Makerfabs/Home-Assistant-Mic-and-Speaker/README.md

# Makerfabs Home Assistant Mic and Speaker

## Intruduce
[Product Link]()

[Wiki Link]()
