Makerfabs/Home-Assistant-Mic-and-Speaker/Hardware/Mic and Speaker for Home Assistant V2.0.PDF

# POWER

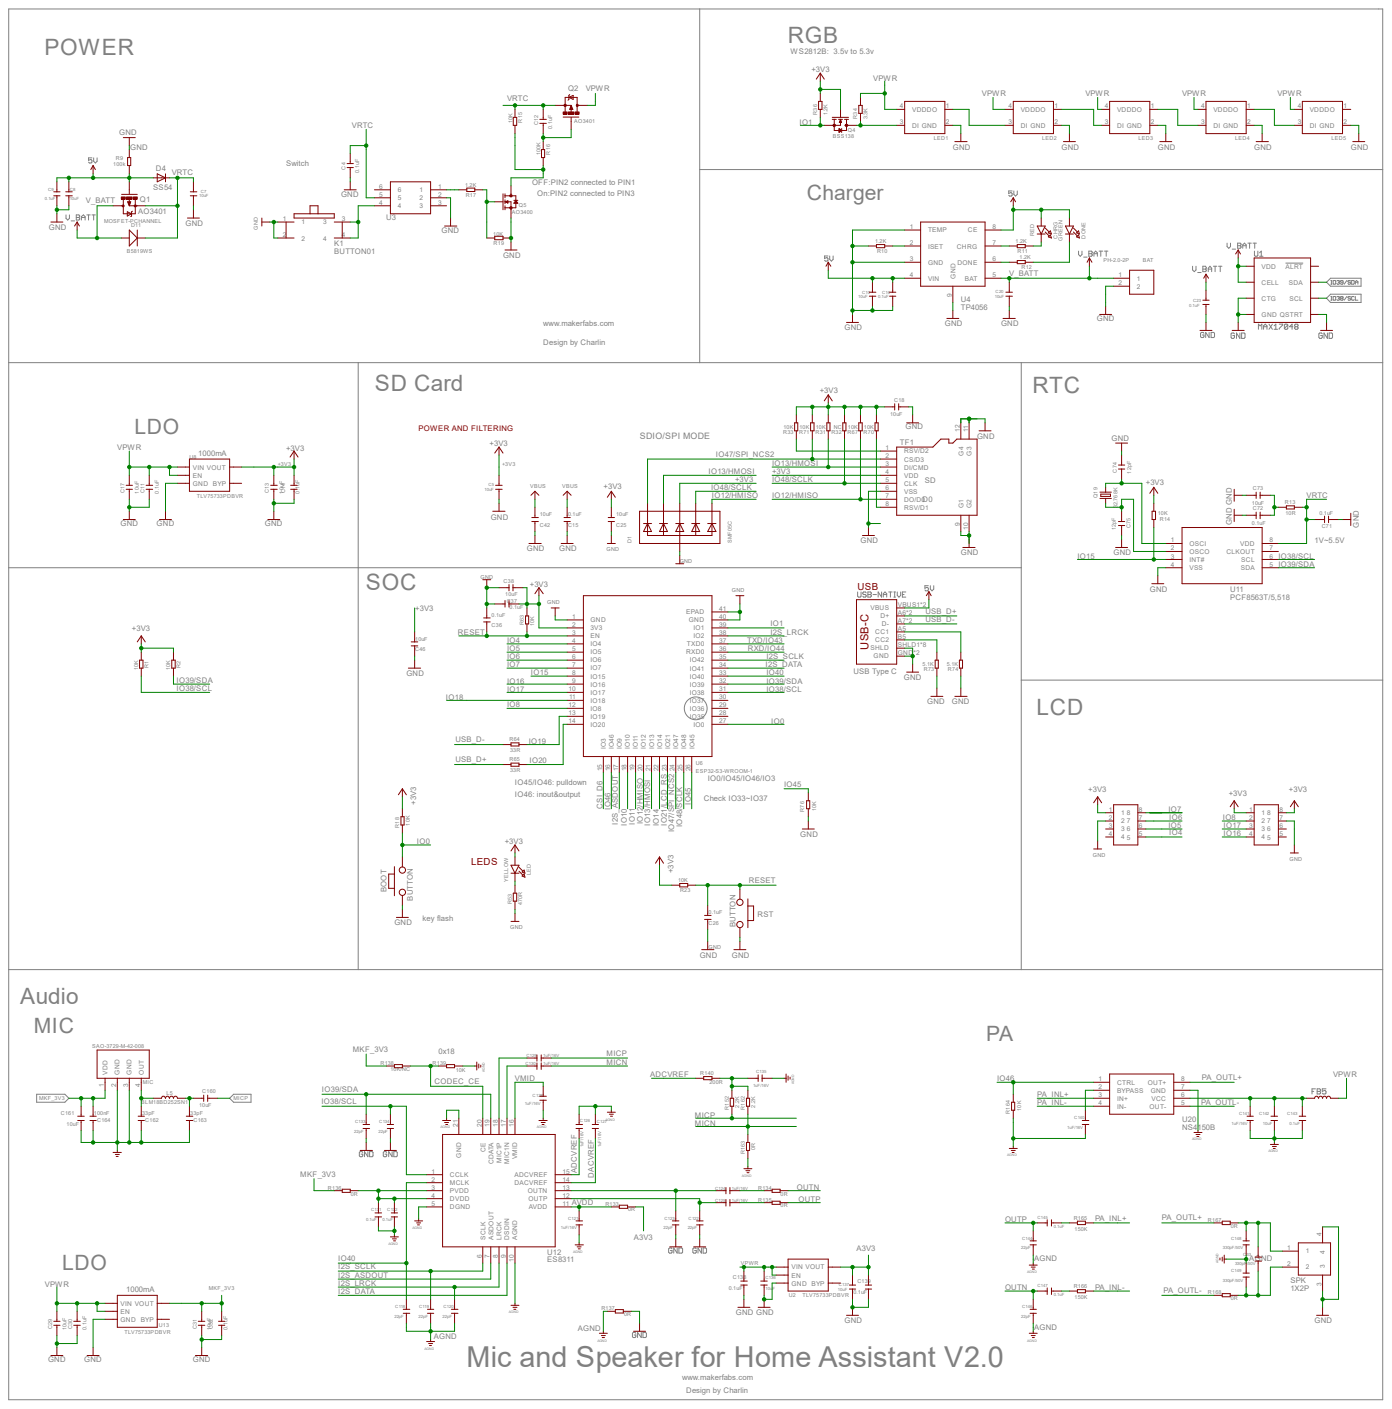
[picture p1: page 1]

IO13/HMOSI | | DI/CMD 3

RSV/D2 1 CS/D3 2 SD D0

+3V3 IO48/SCLK | CLK 5
