Makerfabs/Home-Assistant-Mic-and-Speaker/Hardware/HA LCD1.14 V2.0.PDF

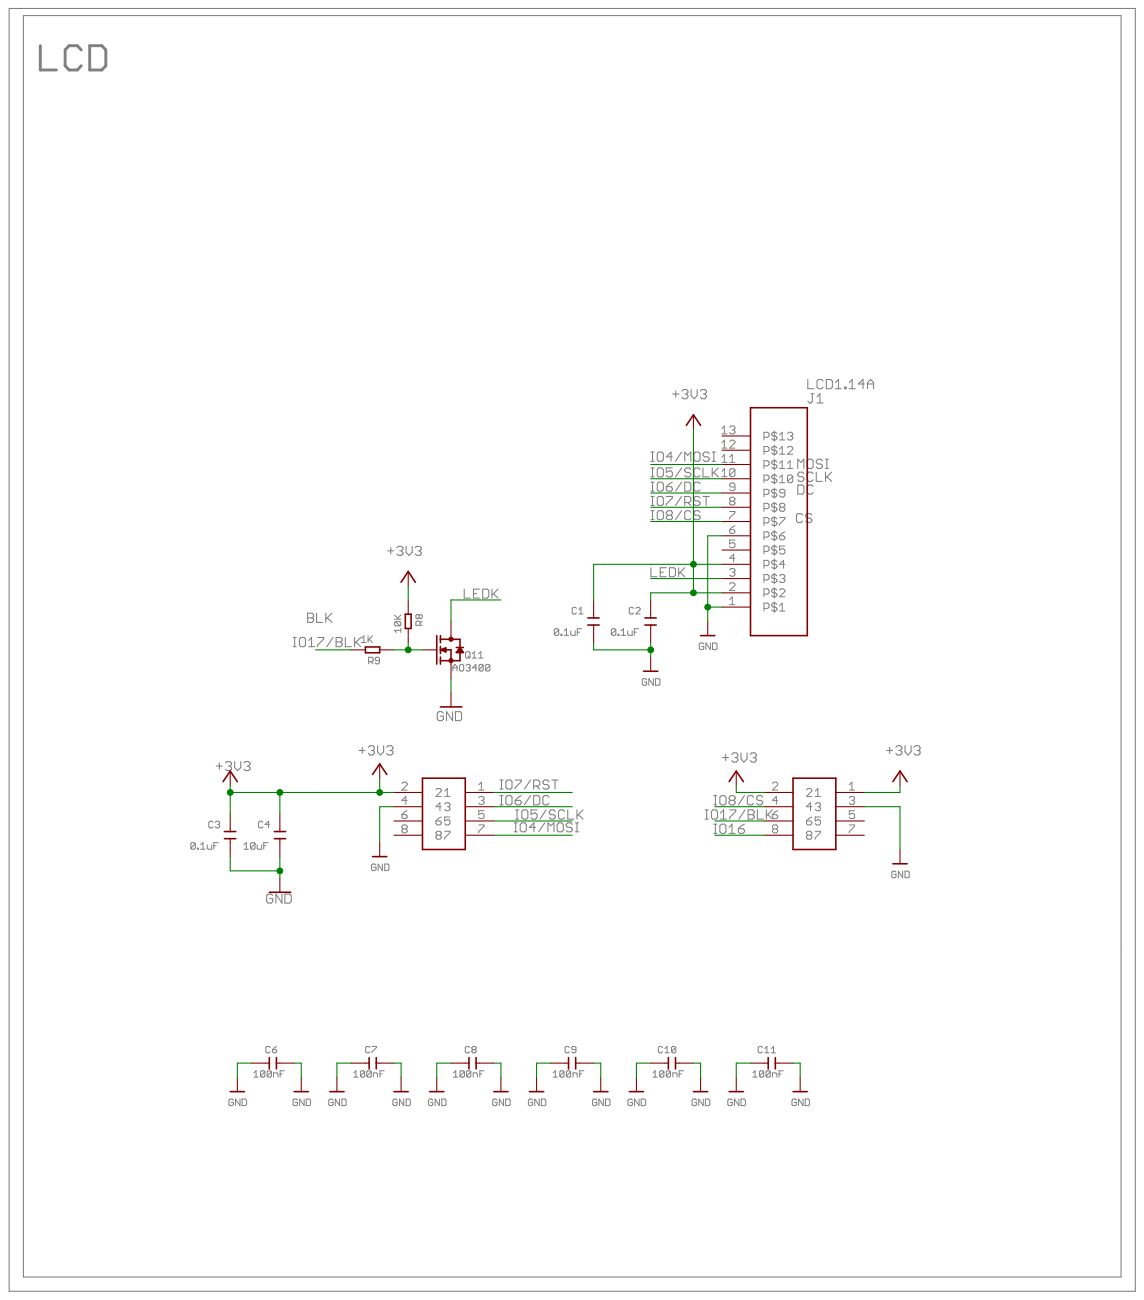
[picture p2: page 1]
