Makerfabs/Home-Assistant-Mic-and-Speaker/Hardware/Mic and Speaker for Home Assistant V2.0.brd

## EAGLE design Hardware/Mic and Speaker for Home Assistant V2.0.brd (2026-05-20)

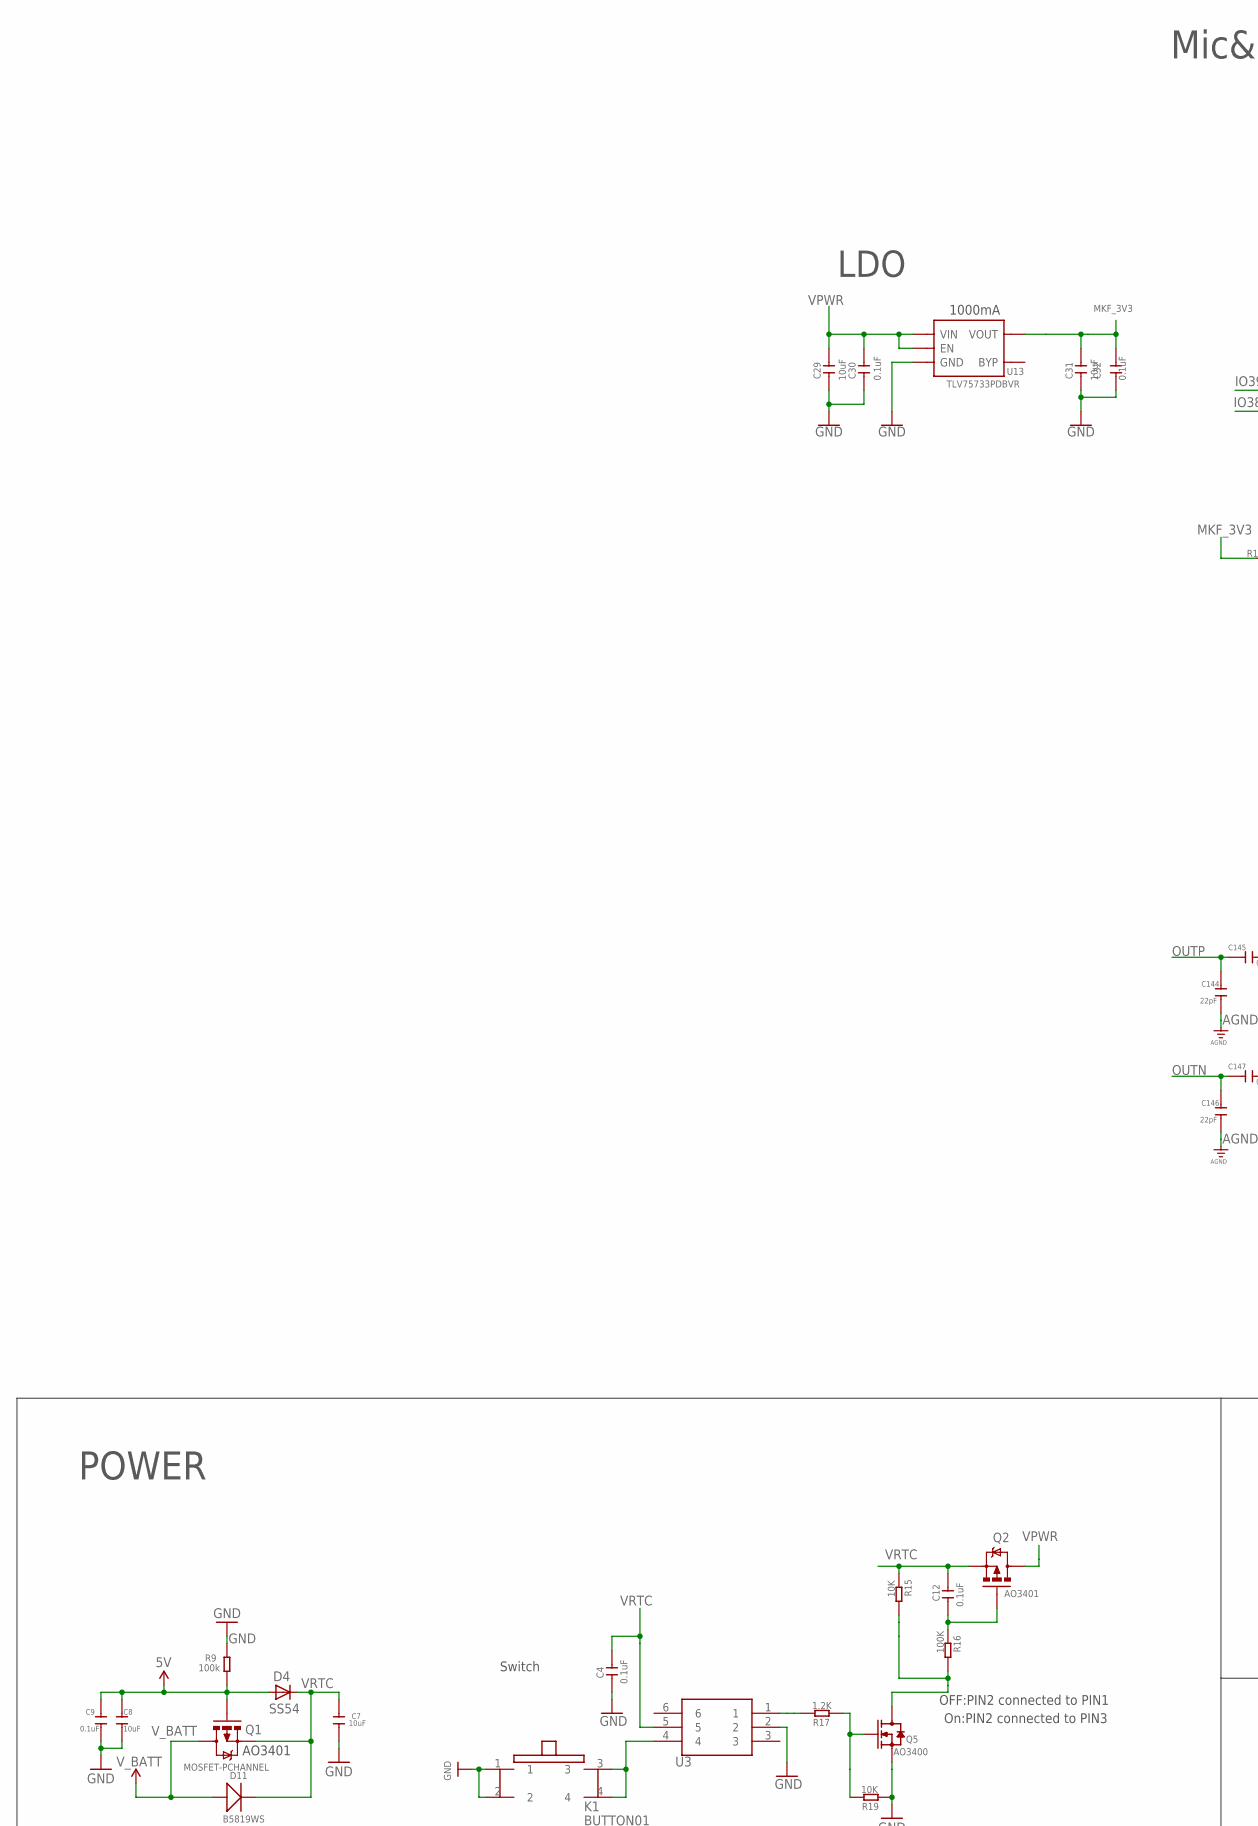
[picture p3: schematic Mic and Speaker for Home Assistant V2.0.sch, part in row 1, column 1]

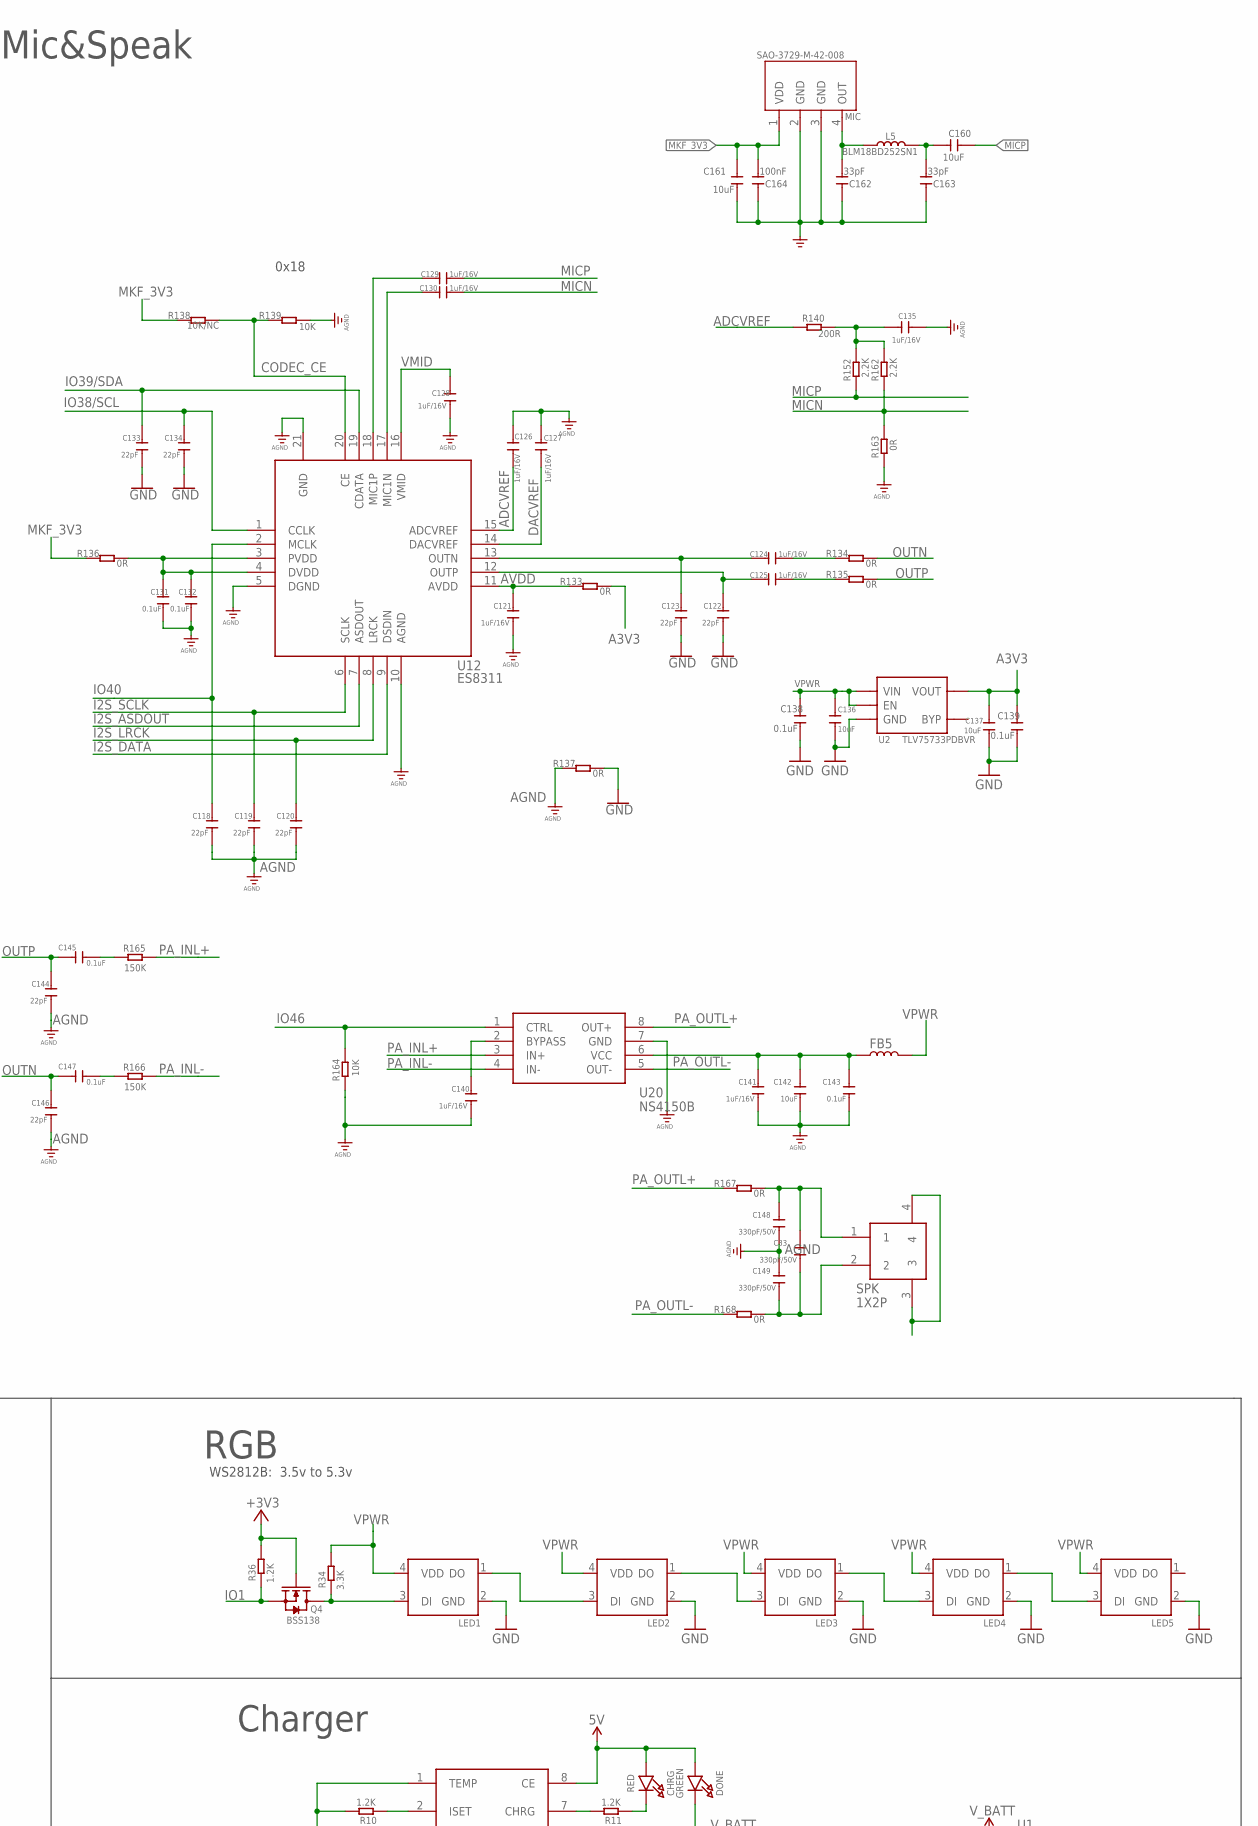
[picture p4: schematic Mic and Speaker for Home Assistant V2.0.sch, part in row 1, column 2]

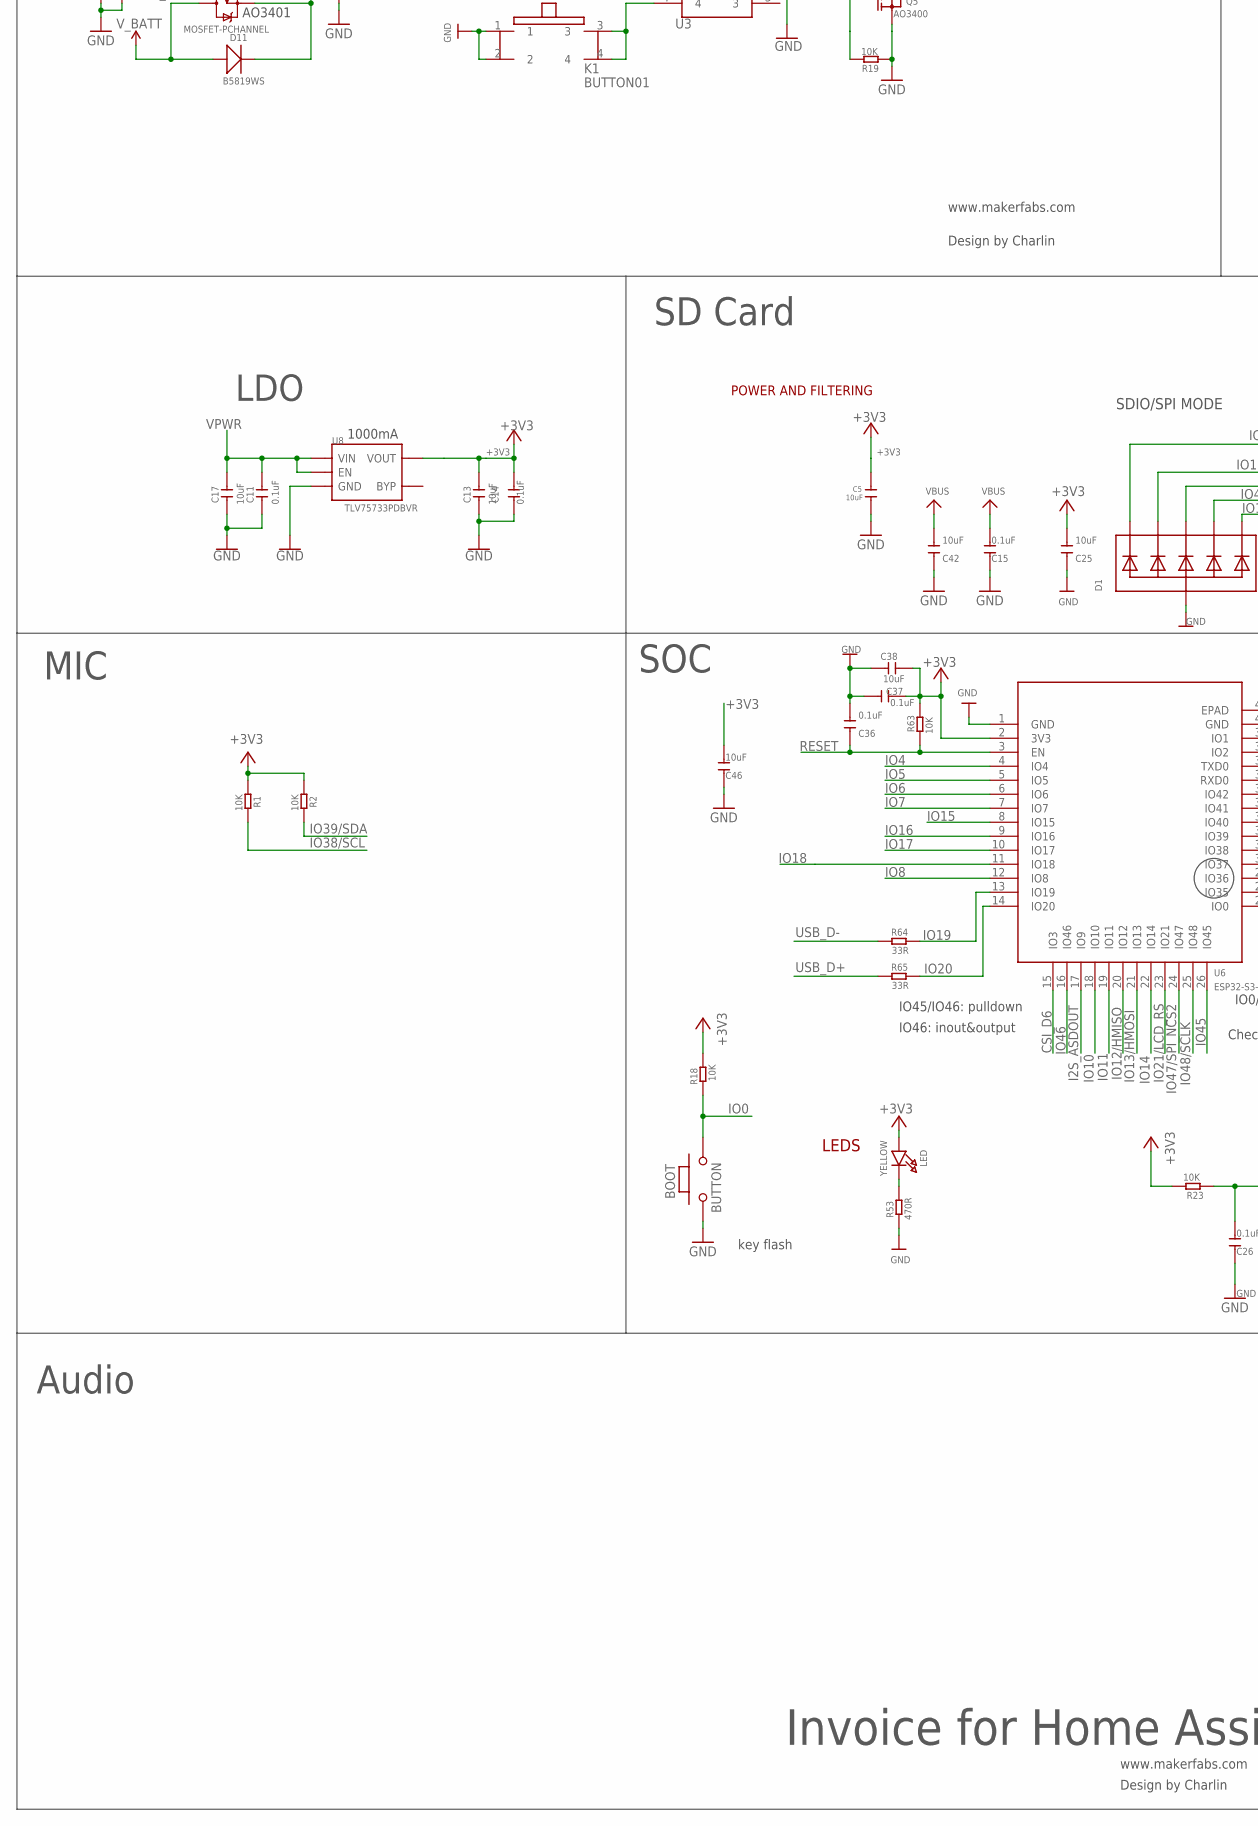
[picture p5: schematic Mic and Speaker for Home Assistant V2.0.sch, part in row 2, column 1]

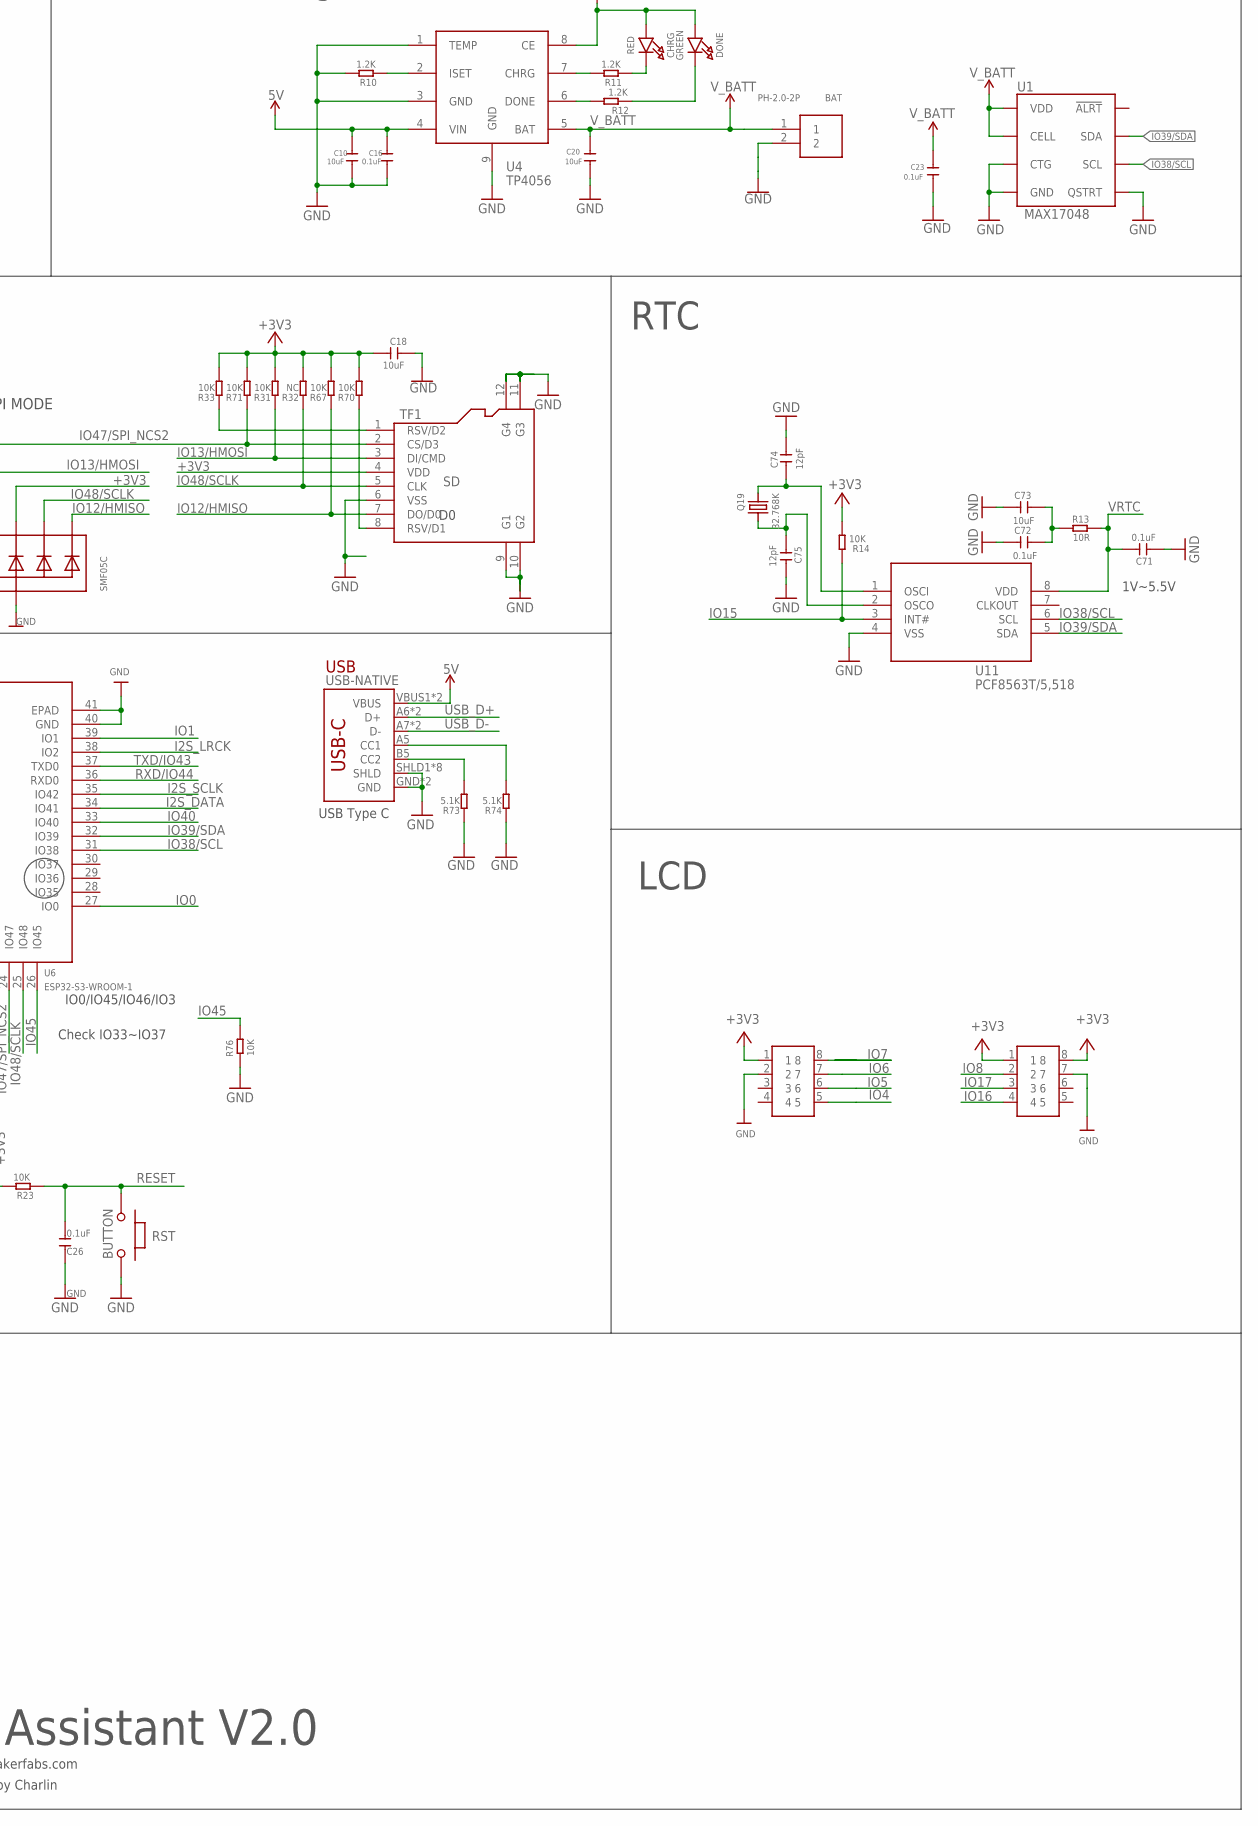
[picture p6: schematic Mic and Speaker for Home Assistant V2.0.sch, part in row 2, column 2]

Parts:
BAT: PH-2.0-2P
BOOT: BUTTON; 157SW
C4, C11, C12, C14, C15, C26, C30, C32, C36, C37, C71, C72: 0.1uF; DISCRETE_C0603
C5, C7, C8, C10, C20, C136, C137, C142, C160, C161: 10uF; C0603
C9, C16, C23, C131, C132, C138, C139, C143, C145, C147: 0.1uF; C0603
C13, C17, C18, C25, C29, C31, C38, C42, C46, C73: 10uF; DISCRETE_C0603
C33, C148, C149: 330pF/50V; C0603
C74, C75: 12pF; DISCRETE_C0603
C118, C119, C120, C122, C123, C133, C134, C144, C146: 22pF; C0603
C121, C124, C125, C126, C127, C128, C129, C130, C135, C140, C141: 1uF/16V; C0603
C162, C163: 33pF; C0603
C164: 100nF; C0603
CHRG: RED; CHIPLED_0805_NOOUTLINE
D1: SMF05C; SOT363
D4: SS54; DO-214AC
D11: B5819WS; SOD323
DONE: GREEN; CHIPLED_0805_NOOUTLINE
FB5: INDUCTORFB-30OHM; 0603
J1, J2: CON2X4-254P-B; CON2X4-2.54MM-THD
K1: BUTTON01
L5: BLM18BD252SN1; L0603
LED: YELLOW; CHIPLED_0805_NOOUTLINE
LED1, LED2, LED3, LED4, LED5: WS2812B-2020
MIC: SAO-3729-M-42-008; MIC4-SMD-3.76X2.95MM
Q1: MOSFET-PCHANNEL; SOT23-3
Q2: AO3401; SOT23-3
Q4: BSS138; SOT23@1
Q5: AO3400; SOT23@1
Q19: 32.768K; XTAL3215
R1, R2, R14, R15, R18, R19, R23, R63, R76, R139, R164: 10K; R0603
R9: 100k; R0603
R10, R11, R12, R17, R36: 1.2K; R0603
R13: 10R; R0603
R16: 100K; R0603
R31, R33, R67, R70, R71: 10K; DISCRETE_R0603
R32: NC; DISCRETE_R0603
R34: 3.3K; R0603
R53: 470R; R0603
R64, R65: 33R; R0603
R73, R74: 5.1K; DISCRETE_R0603
R133, R134, R135, R136, R137, R163, R167, R168: 0R; R0603
R138: 10K/NC; R0603
R140: 200R; R0603
R152, R162: 2.2K; R0603
R165, R166: 150K; R0603
RST: BUTTON; 157SW
SPK: 1X2P; 1X2P-SMT1.25MM
TF1: SD; 8P-SMD
U1: MAX17048; DFN-8
U2, U8, U13: TLV75733PDBVR; SOT23-5
U3: SW01A; SOT23-6-95P-300L300W
U4: TP4056; SOP8-1.27P
U6: ESP32-S3-WROOM-1
U11: PCF8563T/5,518; SOP8
U12: ES8311; QFN20-40P-300L300W55H
U20: NS4150B; MSOP8-65P-490L300W110H
USB-NATIVE: USB_C5; USB-C-16P-5

Connections:
5V: C8.2, C9.1, C10.1, C16.1, CHRG.A, D4.A, DONE.A, Q1.1 (G), R9.1, U4.4 (VIN), U4.8 (CE), USB-NATIVE.VBUS1 (VBUS), USB-NATIVE.VBUS2 (VBUS)
+3V3: C5.1, C13.2, C14.2, C18.2, C25.2, C37.1, C38.1, C46.2, D1.4 (C3), J1.1, J2.1, J2.8, LED.A, Q4.1 (G), R1.1, R2.1, R14.1, R18.2, R23.2, R31.2, R32.2, R33.2, R36.2, R63.2, R67.2, R70.2, R71.2, TF1.4 (VDD), U6.2 (3V3), U8.5 (VOUT)
A3V3: C137.1, C139.2, R133.2, U2.5 (VOUT)
ADCVREF: C126.2, R140.1, U12.15 (ADCVREF)
AGND: C118.2, C119.2, C120.2, C121.2, C126.1, C127.1, C128.2, C131.2, C132.2, C135.2, C140.2, C141.2, C142.2, C143.2, C144.2, C146.2, C148.2, C149.1, C161.1, C162.2, C163.2, C164.2, MIC.2 (GND), MIC.3 (GND), R137.1, R139.2, R163.1, R164.1, U12.5 (DGND), U12.10 (AGND), U12.21 (GND), U20.7 (GND)
AVDD: C121.1, R133.1, U12.11 (AVDD)
CODEC_CE: R138.2, R139.1, U12.20 (CE)
CSI_D6: U6.15 (IO3)
DACVREF: C127.2, U12.14 (DACVREF)
GND: BAT.2, BOOT.1, C4.1, C5.2, C7.1, C8.1, C9.2, C10.2, C11.1, C13.1, C14.1, C15.1, C16.2, C17.1, C18.1, C20.2, C23.2, C25.1, C26.1, C29.1, C30.1, C31.1, C32.1, C36.2, C37.2, C38.2, C42.1, C46.1, C71.1, C72.1, C73.1, C74.2, C75.2, C122.2, C123.2, C133.2, C134.2, C136.2, C137.2, C138.1, C139.1, D1.2 (A), J1.2, J2.7, K1.1, K1.2, LED1.2 (GND), LED2.2 (GND), LED3.2 (GND), LED4.2 (GND), LED5.2 (GND), Q5.2 (S), R9.2, R10.2, R19.1, R53.1, R73.1, R74.1, R76.1, R137.2, RST.1, SPK.3, SPK.4, TF1.6 (VSS), TF1.9 (G1), TF1.10 (G2), TF1.11 (G3), TF1.12 (G4), U1.1 (CTG), U1.4 (GND), U1.6 (QSTRT), U1.9 (GND), U2.2 (GND), U3.2, U4.1 (TEMP), U4.3 (GND), U4.9 (GND), U6.1 (GND), U6.40 (GND), U6.41 (EPAD), U8.2 (GND), U11.4 (VSS), U13.2 (GND), USB-NATIVE.GND, USB-NATIVE.GND2 (GND), USB-NATIVE.SHLD1 (SHLD), USB-NATIVE.SHLD2 (SHLD), USB-NATIVE.SHLD3 (SHLD), USB-NATIVE.SHLD4 (SHLD), USB-NATIVE.SHLD5 (SHLD), USB-NATIVE.SHLD6 (SHLD), USB-NATIVE.SHLD7 (SHLD), USB-NATIVE.SHLD8 (SHLD)
I2S_ASDOUT: U6.17 (IO9), U12.7 (ASDOUT)
I2S_DATA: U6.34 (IO41), U12.9 (DSDIN)
I2S_LRCK: C120.1, U6.38 (IO2), U12.8 (LRCK)
I2S_SCLK: C119.1, U6.35 (IO42), U12.6 (SCLK)
IO0: BOOT.2, R18.1, U6.27 (IO0)
IO1: Q4.2 (S), R36.1, U6.39 (IO1)
IO4: J1.5, U6.4 (IO4)
IO5: J1.6, U6.5 (IO5)
IO6: J1.7, U6.6 (IO6)
IO7: J1.8, U6.7 (IO7)
IO8: J2.2, U6.12 (IO8)
IO10: U6.18 (IO10)
IO11: U6.19 (IO11)
IO12/HMISO: D1.6 (C5), R67.1, TF1.7 (DO/D0), U6.20 (IO12)
IO13/HMOSI: D1.3 (C2), R31.1, TF1.3 (DI/CMD), U6.21 (IO13)
IO14: U6.22 (IO14)
IO15: R14.2, U6.8 (IO15), U11.3 (INT#)
IO16: J2.4, U6.9 (IO16)
IO17: J2.3, U6.10 (IO17)
IO18: U6.11 (IO18)
IO19: R64.2, U6.13 (IO19)
IO20: R65.2, U6.14 (IO20)
IO21/LCD_RS: U6.23 (IO21)
IO38/SCL: C134.1, R1.2, U1.7 (SCL), U6.31 (IO38), U11.6 (SCL), U12.1 (CCLK)
IO39/SDA: C133.1, R2.2, U1.8 (SDA), U6.32 (IO39), U11.5 (SDA), U12.19 (CDATA)
IO40: C118.1, U6.33 (IO40), U12.2 (MCLK)
IO45: R76.2, U6.26 (IO45)
IO46: R164.2, U6.16 (IO46), U20.1 (CTRL)
IO47/SPI_NCS2: D1.1 (C1), R71.1, TF1.2 (CS/D3), U6.24 (IO47)
IO48/SCLK: D1.5 (C4), R32.1, TF1.5 (CLK), U6.25 (IO48)
MICN: C130.2, R162.1, R163.2
MICP: C129.2, C160.2, R152.1
MKF_3V3: C31.2, C32.2, C161.2, C164.1, MIC.1 (VDD), R136.1, R138.1, U13.5 (VOUT)
unnamed: R10.1, U4.2 (ISET)
unnamed: R11.2, U4.7 (CHRG)
unnamed: R12.2, U4.6 (DONE)
unnamed: C12.1, Q2.1 (G), R16.1
unnamed: CHRG.C, R11.1
unnamed: DONE.C, R12.1
unnamed: Q5.3 (D), R15.2, R16.2
unnamed: LED.C, R53.2
unnamed: LED1.3 (DI), Q4.3 (D), R34.1
unnamed: R33.1, TF1.1 (RSV/D2)
unnamed: R70.1, TF1.8 (RSV/D1)
unnamed: K1.3, K1.4, U3.4
unnamed: Q5.1 (G), R17.1, R19.2
unnamed: R17.2, U3.1
unnamed: C145.2, R165.1
unnamed: LED1.1 (DO), LED2.3 (DI)
unnamed: LED2.1 (DO), LED3.3 (DI)
unnamed: C147.2, R166.1
unnamed: C33.2, C149.2, R168.2, SPK.2
unnamed: LED3.1 (DO), LED4.3 (DI)
unnamed: LED4.1 (DO), LED5.3 (DI)
unnamed: R74.2, USB-NATIVE.A5 (CC1)
unnamed: R73.2, USB-NATIVE.B5 (CC2)
unnamed: C160.1, C163.1, L5.2
unnamed: C130.1, U12.17 (MIC1N)
unnamed: C162.1, L5.1, MIC.4 (OUT)
unnamed: C122.1, C125.1, U12.12 (OUTP)
unnamed: C123.1, C124.1, U12.13 (OUTN)
unnamed: C124.2, R134.1
unnamed: C125.2, R135.1
unnamed: C129.1, U12.18 (MIC1P)
unnamed: C131.1, C132.1, R136.2, U12.3 (PVDD), U12.4 (DVDD)
unnamed: C135.1, R140.2, R152.2, R162.2
unnamed: C140.1, U20.2 (BYPASS)
unnamed: C141.1, C142.1, C143.1, FB5.1, U20.6 (VCC)
unnamed: C74.1, Q19.P$1 (1), U11.1 (OSCI)
unnamed: C75.1, Q19.P$2 (2), U11.2 (OSCO)
unnamed: C72.2, C73.2, R13.1
unnamed: C33.1, C148.1, R167.2, SPK.1
OUTN: C146.1, C147.1, R134.2
OUTP: C144.1, C145.1, R135.2
PA_INL+: R165.2, U20.3 (IN+)
PA_INL-: R166.2, U20.4 (IN-)
PA_OUTL+: R167.1, U20.8 (OUT+)
PA_OUTL-: R168.1, U20.5 (OUT-)
RESET: C26.2, C36.1, R23.1, R63.1, RST.2, U6.3 (EN)
RXD/IO44: U6.36 (RXD0)
TXD/IO43: U6.37 (TXD0)
USB_D+: R65.1, USB-NATIVE.A6 (D+), USB-NATIVE.B6 (D+)
USB_D-: R64.1, USB-NATIVE.A7 (D-), USB-NATIVE.B7 (D-)
VMID: C128.1, U12.16 (VMID)
VPWR: C11.2, C15.2, C17.2, C29.2, C30.2, C42.2, C136.1, C138.2, FB5.2, LED1.4 (VDD), LED2.4 (VDD), LED3.4 (VDD), LED4.4 (VDD), LED5.4 (VDD), Q2.3 (D), R34.2, U2.1 (VIN), U2.3 (EN), U8.1 (VIN), U8.3 (EN), U13.1 (VIN), U13.3 (EN)
VRTC: C4.2, C7.2, C12.2, C71.2, D4.C, D11.-, Q1.2 (S), Q2.2 (S), R13.2, R15.1, U3.5, U11.8 (VDD)
V_BATT: BAT.1, C20.1, C23.1, D11.+, Q1.3 (D), U1.2 (CELL), U1.3 (VDD), U4.5 (BAT)

Notes on the sheet:
www.makerfabs.com
Design by Charlin
LEDS
POWER AND FILTERING
key flash
Invoice for Home Assistant V2.0
POWER
SD Card
IO45/IO46: pulldown
IO46: inout&output
USB
USB Type C
IO0/IO45/IO46/IO3
Check IO33~IO37
SOC
SDIO/SPI MODE
Charger
AO3401
1V~5.5V
WS2812B: 3.5v to 5.3v
RGB
Switch
On:PIN2 connected to PIN3
OFF:PIN2 connected to PIN1
1000mA
LDO
LCD
RTC
MIC
Audio
Mic&Speak
0x18

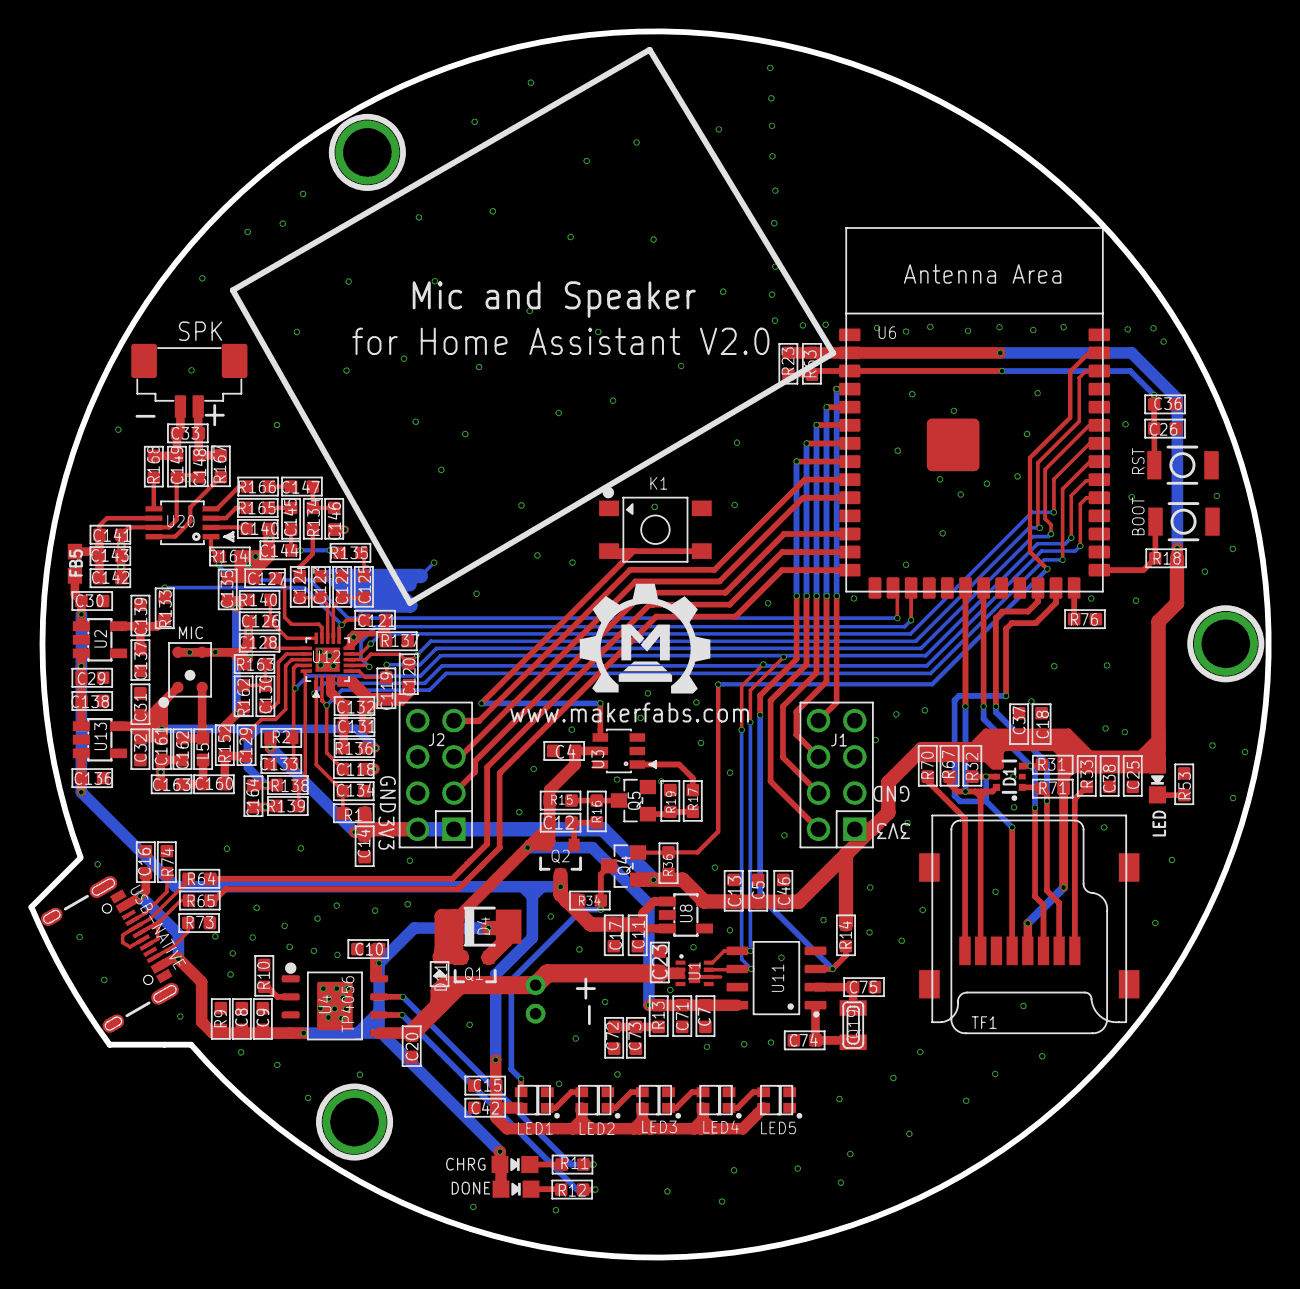
[picture p7: board Mic and Speaker for Home Assistant V2.0.brd from above]

Board: 2 copper layers, 86.8 x 86.0 mm, 154 parts (1 on the bottom side), 89 nets.

Other parts of the board:
U$1: MAKERFABS_0.3
