Makerfabs/Home-Assistant-Mic-and-Speaker/(commit log)

2026-05-20 fix yaml
    [Mic and Speaker for Home Assistant V2.0.sch]
2026-05-20 Add hardware
    [Mic and Speaker for Home Assistant V2.0.brd]
